vinodhiniceg/LVDT_project-ID-337/lvs/README.md

## LVS

Results of the LVS procedure for the blocks:

- charge pump
- colpitts + slope amp
- strongARM latch

are provided in this folder.
