vinodhiniceg/LVDT_project-ID-337/xschem/README.md

## Schematic Files

### Integrated Colpitts Oscillator and Slope Amplifier

The schematic file is `colpitts_slopeamp.sch` and it contains the testbench to run the transient simulation.

### FDC

The top level block is named `FDC_complete_loop.sch` and it contains the whole FDC (including the digital portions built using standard cells and custom made cells).
