vinodhiniceg/LVDT_project-ID-337/layout/magic/README.md

### Layout

The flattened layout files are as follows:

1. `chargepump_flat.mag`
2. `colpitts_slopeamp_flat.mag`
3. `strongarmlatch_flat.mag`
