vinodhiniceg/LVDT_project-ID-337/postlayout/colpitts_slopeamp_postlayout.png

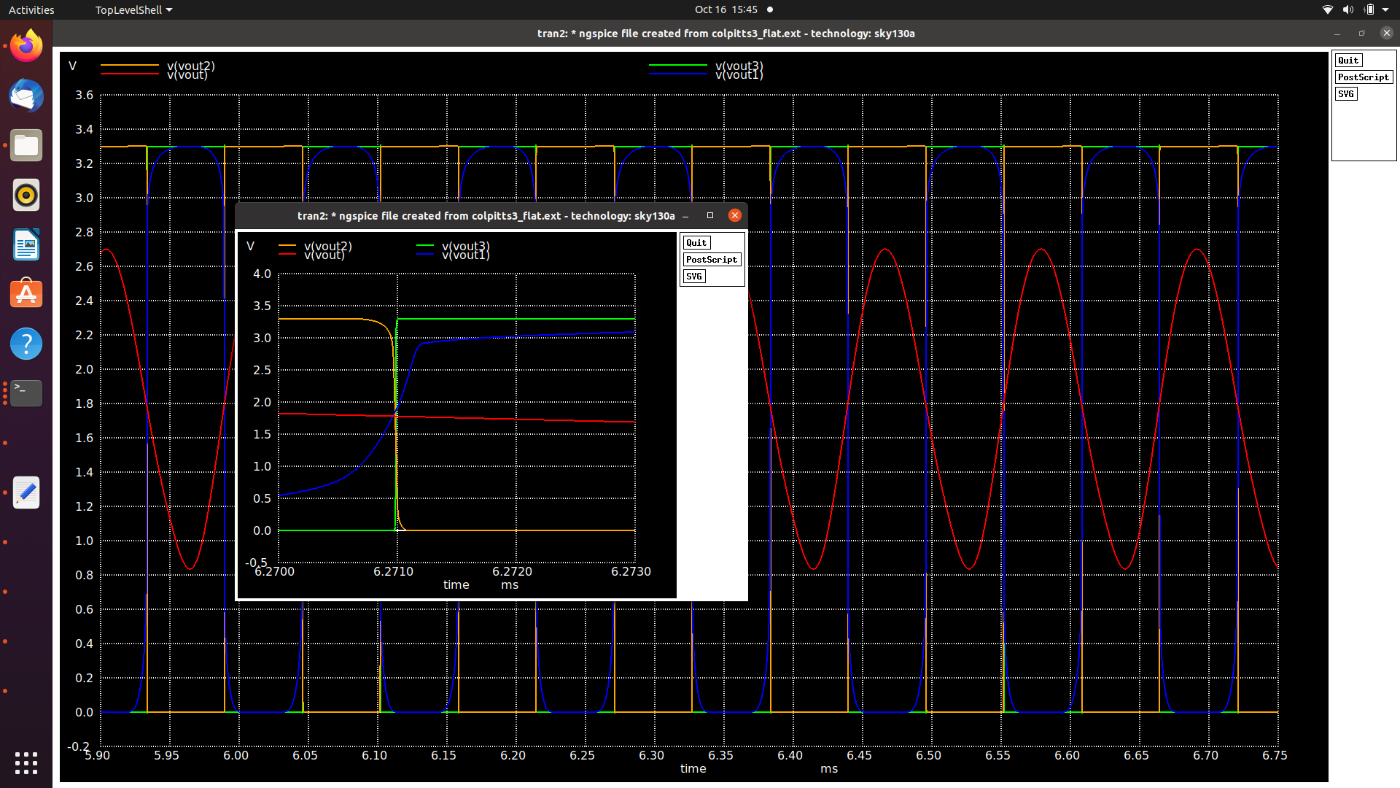
postlayout/colpitts_slopeamp_postlayout.png
