vinodhiniceg/LVDT_project-ID-337/postlayout/chargepump_postextracted.spice

**.subckt chargepump
V2 out1b vssa pulse 3.3 0 1n 1n 1n 50u 100u
V5 vdda vssa 3.3
C10 vc vssa 100p m=1
I1 Iin vssa 1u
V4 out2 vssa pulse 0 3.3 50u 1n 1n 45u 100u
V1 vssa GND 0

X0 dg.t2 dg.t1 vssa vssa sky130_fd_pr__nfet_g5v0d10v5 ad=0p pd=0u as=0p ps=0u w=1e+06u l=1e+06u
X1 vdda.t4 Iin.t0 Iin.t1 vdda.t2 sky130_fd_pr__pfet_g5v0d10v5 ad=0p pd=0u as=0p ps=0u w=1e+06u l=1e+06u
X2 vssa dg.t3 nc.t1 vssa sky130_fd_pr__nfet_g5v0d10v5 ad=0p pd=0u as=0p ps=0u w=1e+06u l=1e+06u
X3 nc dg vssa vssa sky130_fd_pr__nfet_g5v0d10v5 ad=0p pd=0u as=0p ps=0u w=1e+06u l=1e+06u M=33
X4 vdda.t3 Iin.t2 pc.t0 vdda.t2 sky130_fd_pr__pfet_g5v0d10v5 ad=0p pd=0u as=0p ps=0u w=1e+06u l=1e+06u
X5 dg.t0 Iin.t3 vdda.t1 vdda.t0 sky130_fd_pr__pfet_g5v0d10v5 ad=0p pd=0u as=0p ps=0u w=1e+06u l=1e+06u
X6 vc out1b pc.t1 vdda.t2 sky130_fd_pr__pfet_g5v0d10v5 ad=0p pd=0u as=0p ps=0u w=1e+06u l=1e+06u
X7 vssa dg dg vssa sky130_fd_pr__nfet_g5v0d10v5 ad=0p pd=0u as=0p ps=0u w=1e+06u l=1e+06u M=9
X8 nc.t0 out2 vc vssa sky130_fd_pr__nfet_g5v0d10v5 ad=0p pd=0u as=0p ps=0u w=1e+06u l=1e+06u
X9 vdda Iin Iin vdda sky130_fd_pr__pfet_g5v0d10v5 ad=0p pd=0u as=0p ps=0u w=1e+06u l=1e+06u M=9
X10 pc Iin vdda vdda sky130_fd_pr__pfet_g5v0d10v5 ad=0p pd=0u as=0p ps=0u w=1e+06u l=1e+06u M=39
X11 vc out1b pc vdda sky130_fd_pr__pfet_g5v0d10v5 ad=0p pd=0u as=0p ps=0u w=1e+06u l=1e+06u M=9
X12 vc out2 nc vssa sky130_fd_pr__nfet_g5v0d10v5 ad=0p pd=0u as=0p ps=0u w=1e+06u l=1e+06u M=9
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
C0 nc vssa 16.05fF
C1 dg vssa 13.35fF
C2 vdda vssa 55.44fF
C3 vdda.t2 vssa 24.26fF
**** begin user architecture code

.lib ~/open_pdks/sky130/sky130A/libs.tech/ngspice/sky130.lib.spice tt
.include /home/vinodhini/open_pdks/sky130/sky130A/libs.ref/sky130_fd_sc_hvl/spice/sky130_fd_sc_hvl.spice

*.MODEL swmod SW(VT=0.0 VH=0.01 RON=1 ROFF=10000000000)
.param mc_mm_switch=0
.param mc_pr_switch=0


.tran 2.5u 2.5m
.options gmin=1E-11
.options savecurrents
.save out1b out2 vc

**** end user architecture code
**.ends
.GLOBAL GND
** flattened .save nodes
.save out1b out2 vc
.end
