vinodhiniceg/LVDT_project-ID-337/postlayout/colpitts_slopeamp_postextracted.spice

* NGSPICE file created from colpitts4_flat.ext - technology: sky130A


* Top level circuit colpitts4_flat

X0 vout2.t1 vout1.t2 vdda vdda sky130_fd_pr__pfet_g5v0d10v5 ad=0p pd=0u as=0p ps=0u w=3e+06u l=3e+06u
X1 bot bot bot bot sky130_fd_pr__nfet_g5v0d10v5 ad=0p pd=0u as=0p ps=0u w=3e+06u l=3e+06u M=138
X2 vout2 vout1 vdda vdda sky130_fd_pr__pfet_g5v0d10v5 ad=0p pd=0u as=0p ps=0u w=3e+06u l=3e+06u M=199
X3 bot bot bot bot sky130_fd_pr__nfet_g5v0d10v5 ad=0p pd=0u as=0p ps=0u w=5e+06u l=5e+06u M=1450
X4 vdda vdda vdda vdda sky130_fd_pr__pfet_g5v0d10v5 ad=0p pd=0u as=0p ps=0u w=3e+06u l=3e+06u M=1016
X5 vcap.t0 vin1 vout.t0 bot sky130_fd_pr__nfet_g5v0d10v5 ad=0p pd=0u as=0p ps=0u w=5e+06u l=5e+06u
X6 bot vout1.t3 vout2.t0 bot sky130_fd_pr__nfet_g5v0d10v5 ad=0p pd=0u as=0p ps=0u w=3e+06u l=3e+06u
X7 vout vin1 vcap bot sky130_fd_pr__nfet_g5v0d10v5 ad=0p pd=0u as=0p ps=0u w=5e+06u l=5e+06u M=524
X8 vout1.t0 vout.t1 vdda vdda sky130_fd_pr__pfet_g5v0d10v5 ad=0p pd=0u as=0p ps=0u w=3e+06u l=3e+06u
X9 vout1 vout vdda vdda sky130_fd_pr__pfet_g5v0d10v5 ad=0p pd=0u as=0p ps=0u w=3e+06u l=3e+06u M=183
X10 bot vin2 vcap.t1 bot sky130_fd_pr__nfet_g5v0d10v5 ad=0p pd=0u as=0p ps=0u w=5e+06u l=5e+06u
X11 vout3.t1 vout2.t2 vdda vdda sky130_fd_pr__pfet_g5v0d10v5 ad=0p pd=0u as=0p ps=0u w=3e+06u l=3e+06u
X12 vcap vin2 bot bot sky130_fd_pr__nfet_g5v0d10v5 ad=0p pd=0u as=0p ps=0u w=5e+06u l=5e+06u M=199
X13 vdda vout2 vout3 vdda sky130_fd_pr__pfet_g5v0d10v5 ad=0p pd=0u as=0p ps=0u w=3e+06u l=3e+06u M=123
X14 vout3.t0 vout2.t3 bot bot sky130_fd_pr__nfet_g5v0d10v5 ad=0p pd=0u as=0p ps=0u w=3e+06u l=3e+06u
X15 vout2 vout1 bot bot sky130_fd_pr__nfet_g5v0d10v5 ad=0p pd=0u as=0p ps=0u w=3e+06u l=3e+06u M=24
X16 bot vout.t2 vout1.t1 bot sky130_fd_pr__nfet_g5v0d10v5 ad=0p pd=0u as=0p ps=0u w=3e+06u l=3e+06u
X17 vout1 vout bot bot sky130_fd_pr__nfet_g5v0d10v5 ad=0p pd=0u as=0p ps=0u w=3e+06u l=3e+06u M=19
X18 vout3 vout2 bot bot sky130_fd_pr__nfet_g5v0d10v5 ad=0p pd=0u as=0p ps=0u w=3e+06u l=3e+06u M=23
X19 a_85326_53811# a_83611_53805# a_85147_53811# vdda sky130_fd_pr__pfet_g5v0d10v5 ad=0p pd=0u as=0p ps=0u w=420000u l=500000u
X20 vout3.t2 bot sky130_fd_pr__cap_mim_m3_1 l=2e+07u w=2.5e+07u
X21 a_84193_53900# a_83611_53805# a_83724_53900# vdda sky130_fd_pr__pfet_g5v0d10v5 ad=0p pd=0u as=0p ps=0u w=420000u l=500000u
X22 vout2.t4 bot sky130_fd_pr__cap_mim_m3_1 l=2e+07u w=2.5e+07u
X23 a_85659_53375# vdda bot bot sky130_fd_pr__nfet_g5v0d10v5 ad=0p pd=0u as=0p ps=0u w=420000u l=500000u
X24 a_83611_53805# a_83302_53375.t2 vdda vdda sky130_fd_pr__pfet_g5v0d10v5 ad=0p pd=0u as=0p ps=0u w=750000u l=500000u
X25 vdda clkin a_83302_53375.t1 vdda sky130_fd_pr__pfet_g5v0d10v5 ad=0p pd=0u as=0p ps=0u w=750000u l=500000u
X26 vout1.t4 bot sky130_fd_pr__cap_mim_m3_1 l=2e+07u w=2.5e+07u
X27 a_84391_53774# a_84193_53900# bot bot sky130_fd_pr__nfet_g5v0d10v5 ad=0p pd=0u as=0p ps=0u w=750000u l=500000u
X28 vdda a_85147_53811# a_85921_53475# vdda sky130_fd_pr__pfet_g5v0d10v5 ad=0p pd=0u as=0p ps=0u w=750000u l=500000u
X29 a_84363_53441# a_83611_53805# a_84193_53900# bot sky130_fd_pr__nfet_g5v0d10v5 ad=0p pd=0u as=0p ps=0u w=420000u l=500000u
X30 bot a_85368_53685# a_85361_53375# bot sky130_fd_pr__nfet_g5v0d10v5 ad=0p pd=0u as=0p ps=0u w=420000u l=500000u
X31 dfout a_85921_53475# bot bot sky130_fd_pr__nfet_g5v0d10v5 ad=0p pd=0u as=0p ps=0u w=750000u l=500000u
X32 a_84391_53774# a_84193_53900# vdda vdda sky130_fd_pr__pfet_g5v0d10v5 ad=0p pd=0u as=0p ps=0u w=1e+06u l=500000u
X33 bot a_85147_53811# a_85921_53475# bot sky130_fd_pr__nfet_g5v0d10v5 ad=0p pd=0u as=0p ps=0u w=420000u l=500000u
X34 vdda vdda a_83724_53900# vdda sky130_fd_pr__pfet_g5v0d10v5 ad=0p pd=0u as=0p ps=0u w=420000u l=500000u
X35 a_84349_53900# a_83302_53375.t3 a_84193_53900# vdda sky130_fd_pr__pfet_g5v0d10v5 ad=0p pd=0u as=0p ps=0u w=420000u l=500000u
X36 a_84193_53900# vdda vdda vdda sky130_fd_pr__pfet_g5v0d10v5 ad=0p pd=0u as=0p ps=0u w=420000u l=500000u
X37 vdda a_85368_53685# a_85326_53811# vdda sky130_fd_pr__pfet_g5v0d10v5 ad=0p pd=0u as=0p ps=0u w=420000u l=500000u
X38 a_83611_53805# a_83302_53375.t4 bot bot sky130_fd_pr__nfet_g5v0d10v5 ad=0p pd=0u as=0p ps=0u w=420000u l=500000u
X39 vout3 bot sky130_fd_pr__cap_mim_m3_1 l=2e+07u w=2.5e+07u
X40 bot clkin a_83302_53375.t0 bot sky130_fd_pr__nfet_g5v0d10v5 ad=0p pd=0u as=0p ps=0u w=420000u l=500000u
X41 a_83909_53441# vdda bot bot sky130_fd_pr__nfet_g5v0d10v5 ad=0p pd=0u as=0p ps=0u w=420000u l=500000u
X42 vdda a_84391_53774# a_84349_53900# vdda sky130_fd_pr__pfet_g5v0d10v5 ad=0p pd=0u as=0p ps=0u w=420000u l=500000u
X43 a_85147_53811# a_83302_53375.t5 a_84391_53774# vdda sky130_fd_pr__pfet_g5v0d10v5 ad=0p pd=0u as=0p ps=0u w=1e+06u l=500000u
X44 vout2 bot sky130_fd_pr__cap_mim_m3_1 l=2e+07u w=2.5e+07u
X45 a_83724_53900# vout3.t3 a_83909_53441# bot sky130_fd_pr__nfet_g5v0d10v5 ad=0p pd=0u as=0p ps=0u w=420000u l=500000u
X46 vout1 bot sky130_fd_pr__cap_mim_m3_1 l=2e+07u w=2.5e+07u
X47 vout2 bot sky130_fd_pr__cap_mim_m3_1 l=2e+07u w=2.5e+07u
X48 bot vdda a_84505_53441# bot sky130_fd_pr__nfet_g5v0d10v5 ad=0p pd=0u as=0p ps=0u w=420000u l=500000u
X49 a_83724_53900# vout3.t4 vdda vdda sky130_fd_pr__pfet_g5v0d10v5 ad=0p pd=0u as=0p ps=0u w=420000u l=500000u
X50 vdda a_85147_53811# a_85368_53685# vdda sky130_fd_pr__pfet_g5v0d10v5 ad=0p pd=0u as=0p ps=0u w=420000u l=500000u
X51 a_85368_53685# vdda vdda vdda sky130_fd_pr__pfet_g5v0d10v5 ad=0p pd=0u as=0p ps=0u w=420000u l=500000u
X52 a_85361_53375# a_83302_53375.t6 a_85147_53811# bot sky130_fd_pr__nfet_g5v0d10v5 ad=0p pd=0u as=0p ps=0u w=420000u l=500000u
X53 a_85368_53685# a_85147_53811# a_85659_53375# bot sky130_fd_pr__nfet_g5v0d10v5 ad=0p pd=0u as=0p ps=0u w=420000u l=500000u
X54 vout1 bot sky130_fd_pr__cap_mim_m3_1 l=2e+07u w=2.5e+07u
X55 a_84193_53900# a_83302_53375.t7 a_83724_53900# bot sky130_fd_pr__nfet_g5v0d10v5 ad=0p pd=0u as=0p ps=0u w=420000u l=500000u
X56 a_85147_53811# a_83611_53805# a_84391_53774# bot sky130_fd_pr__nfet_g5v0d10v5 ad=0p pd=0u as=0p ps=0u w=750000u l=500000u
X57 vout1 bot sky130_fd_pr__cap_mim_m3_1 l=2e+07u w=2.5e+07u
X58 vout1 bot sky130_fd_pr__cap_mim_m3_1 l=2e+07u w=2.5e+07u
X59 dfout a_85921_53475# vdda vdda sky130_fd_pr__pfet_g5v0d10v5 ad=0p pd=0u as=0p ps=0u w=1.5e+06u l=500000u
X60 a_84505_53441# a_84391_53774# a_84363_53441# bot sky130_fd_pr__nfet_g5v0d10v5 ad=0p pd=0u as=0p ps=0u w=420000u l=500000u
R0 vout1.n0 vout1.t1 1554.43
R1 vout1 vout1.n279 1537.99
R2 vout1.n280 vout1 703.239
R3 vout1.n246 vout1.n245 381.257
R4 vout1.n159 vout1.n153 368.573
R5 vout1.n153 vout1.n95 368.573
R6 vout1.n248 vout1.n247 368.573
R7 vout1.n247 vout1.n246 363.643
R8 vout1.n248 vout1.n43 325.302
R9 vout1.n240 vout1.n239 317.928
R10 vout1.n159 vout1.n158 305.036
R11 vout1.n239 vout1.n233 271.976
R12 vout1.n280 vout1.t0 265.444
R13 vout1.n223 vout1.n222 257.825
R14 vout1.n212 vout1.n95 237.666
R15 vout1.n222 vout1.n221 235.213
R16 vout1.n89 vout1.n54 223.973
R17 vout1.n254 vout1.n38 159.889
R18 vout1.n170 vout1.n169 153.573
R19 vout1.n171 vout1.n119 153.566
R20 vout1.n107 vout1.n106 153.547
R21 vout1.n101 vout1.n100 153.516
R22 vout1.n148 vout1.n141 153.482
R23 vout1.n164 vout1.n163 152.655
R24 vout1.n207 vout1.n206 152.572
R25 vout1.n201 vout1.n200 152.572
R26 vout1.n33 vout1.n21 152.45
R27 vout1.n27 vout1.n26 152.394
R28 vout1.n260 vout1.n259 152.34
R29 vout1.n60 vout1.n59 152.321
R30 vout1.n44 vout1.n38 152.125
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
R738 vout.n210 vout.n209 48.2
R739 vout.n211 vout.n210 48.2
R740 vout.n55 vout.n54 48.2
R741 vout.n56 vout.n55 48.2
R742 vout.n203 vout.n202 48.2
R743 vout.n204 vout.n203 48.2
R744 vout.n51 vout.n50 48.2
R745 vout.n52 vout.n51 48.2
R746 vout.n108 vout.n107 48.2
R747 vout.n109 vout.n108 48.2
R748 vout.n58 vout.n57 48.2
R749 vout.n59 vout.n58 48.2
R750 vout.n200 vout.n199 48.2
R751 vout.n199 vout.n198 48.2
R752 vout.n196 vout.n195 48.2
R753 vout.n195 vout.n194 48.2
R754 vout.n66 vout.n65 48.2
R755 vout.n67 vout.n66 48.2
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
