vinodhiniceg/LVDT_project-ID-337/postlayout/strongarmlatch_postextraction.spice

**.subckt strongarmlatch

X0 sky130_fd_sc_hvl__inv_1_1/A.t0 sky130_fd_sc_hvl__inv_1_0/A.t3 a_n260_n1316.t1 vssa sky130_fd_pr__nfet_g5v0d10v5 ad=0p pd=0u as=0p ps=0u w=1e+06u l=500000u
X1 vom sky130_fd_sc_hvl__inv_1_0/A.t4 vssa vssa sky130_fd_pr__nfet_g5v0d10v5 ad=0p pd=0u as=0p ps=0u w=750000u l=500000u
X2 vp vm vssa vssa sky130_fd_pr__nfet_g5v0d10v5 ad=0p pd=0u as=0p ps=0u w=750000u l=500000u
X3 a_n260_n1316.t3 clk vdda.t20 vdda.t19 sky130_fd_pr__pfet_g5v0d10v5 ad=0p pd=0u as=0p ps=0u w=1e+06u l=500000u
X4 a_3148_n1460.t1 vref nmos8point5_0/d.t0 vssa sky130_fd_pr__nfet_g5v0d10v5 ad=0p pd=0u as=0p ps=0u w=1e+06u l=500000u
X5 a_n260_n1316.t2 vinp nmos8point5_0/d.t3 vssa sky130_fd_pr__nfet_g5v0d10v5 ad=0p pd=0u as=0p ps=0u w=1e+06u l=500000u
X6 sky130_fd_sc_hvl__inv_1_0/A.t1 sky130_fd_sc_hvl__inv_1_1/A.t3 a_3148_n1460.t0 vssa sky130_fd_pr__nfet_g5v0d10v5 ad=0p pd=0u as=0p ps=0u w=1e+06u l=500000u
X7 vp vm vdda.t11 vdda.t10 sky130_fd_pr__pfet_g5v0d10v5 ad=0p pd=0u as=0p ps=0u w=1.5e+06u l=500000u
X8 a_3148_n1460.t2 vinp nmos8point5_0/d.t2 vdda.t12 sky130_fd_pr__pfet_g5v0d10v5 ad=0p pd=0u as=0p ps=0u w=1e+06u l=500000u
X9 a_3148_n1460.t3 clk vdda.t18 vdda.t17 sky130_fd_pr__pfet_g5v0d10v5 ad=0p pd=0u as=0p ps=0u w=1e+06u l=500000u
X10 sky130_fd_sc_hvl__inv_1_1/A.t2 clk vdda.t16 vdda.t15 sky130_fd_pr__pfet_g5v0d10v5 ad=0p pd=0u as=0p ps=0u w=1e+06u l=500000u
X11 vm vp vssa vssa sky130_fd_pr__nfet_g5v0d10v5 ad=0p pd=0u as=0p ps=0u w=750000u l=500000u
X12 vdda.t14 clk sky130_fd_sc_hvl__inv_1_0/A.t2 vdda.t13 sky130_fd_pr__pfet_g5v0d10v5 ad=0p pd=0u as=0p ps=0u w=1e+06u l=500000u
X13 vssa vom vp vssa sky130_fd_pr__nfet_g5v0d10v5 ad=0p pd=0u as=0p ps=0u w=1e+06u l=500000u
X14 a_n260_n1316.t0 vref nmos8point5_0/d.t1 vdda.t6 sky130_fd_pr__pfet_g5v0d10v5 ad=0p pd=0u as=0p ps=0u w=1e+06u l=500000u
X15 vdda clk sky130_fd_sc_hvl__inv_1_0/A vdda sky130_fd_pr__pfet_g5v0d10v5 ad=0p pd=0u as=0p ps=0u w=1e+06u l=500000u M=7
X16 vdda clk sky130_fd_sc_hvl__inv_1_1/A vdda sky130_fd_pr__pfet_g5v0d10v5 ad=0p pd=0u as=0p ps=0u w=1e+06u l=500000u M=7
X17 vdda.t5 sky130_fd_sc_hvl__inv_1_1/A.t4 sky130_fd_sc_hvl__inv_1_0/A.t0 vdda.t4 sky130_fd_pr__pfet_g5v0d10v5 ad=0p pd=0u as=0p ps=0u w=1e+06u l=500000u
X18 vssa clk nmos8point5_0/d.t4 vssa sky130_fd_pr__nfet_g5v0d10v5 ad=0p pd=0u as=0p ps=0u w=1e+06u l=500000u
X19 vssa clk nmos8point5_0/d vssa sky130_fd_pr__nfet_g5v0d10v5 ad=0p pd=0u as=0p ps=0u w=1e+06u l=500000u M=7
X20 vdda sky130_fd_sc_hvl__inv_1_1/A sky130_fd_sc_hvl__inv_1_0/A vdda sky130_fd_pr__pfet_g5v0d10v5 ad=0p pd=0u as=0p ps=0u w=1e+06u l=500000u M=7
X21 vdda.t3 sky130_fd_sc_hvl__inv_1_1/A.t5 vop vdda.t2 sky130_fd_pr__pfet_g5v0d10v5 ad=0p pd=0u as=0p ps=0u w=1.5e+06u l=500000u
X22 vssa vop vm vssa sky130_fd_pr__nfet_g5v0d10v5 ad=0p pd=0u as=0p ps=0u w=1e+06u l=500000u
X23 sky130_fd_sc_hvl__inv_1_1/A.t1 sky130_fd_sc_hvl__inv_1_0/A.t5 vdda.t9 vdda.t4 sky130_fd_pr__pfet_g5v0d10v5 ad=0p pd=0u as=0p ps=0u w=1e+06u l=500000u
X24 sky130_fd_sc_hvl__inv_1_1/A sky130_fd_sc_hvl__inv_1_0/A vdda vdda sky130_fd_pr__pfet_g5v0d10v5 ad=0p pd=0u as=0p ps=0u w=1e+06u l=500000u M=7
X25 vm vp vdda.t1 vdda.t0 sky130_fd_pr__pfet_g5v0d10v5 ad=0p pd=0u as=0p ps=0u w=1.5e+06u l=500000u
X26 vssa sky130_fd_sc_hvl__inv_1_1/A.t6 vop vssa sky130_fd_pr__nfet_g5v0d10v5 ad=0p pd=0u as=0p ps=0u w=750000u l=500000u
X27 vom sky130_fd_sc_hvl__inv_1_0/A.t6 vdda.t8 vdda.t7 sky130_fd_pr__pfet_g5v0d10v5 ad=0p pd=0u as=0p ps=0u w=1.5e+06u l=500000u
R0 sky130_fd_sc_hvl__inv_1_0/A.n5 sky130_fd_sc_hvl__inv_1_0/A.n4 180.749
R1 sky130_fd_sc_hvl__inv_1_0/A.n12 sky130_fd_sc_hvl__inv_1_0/A.t5 176.013
R2 sky130_fd_sc_hvl__inv_1_0/A.n16 sky130_fd_sc_hvl__inv_1_0/A.n15 174.987
R3 sky130_fd_sc_hvl__inv_1_0/A.n11 sky130_fd_sc_hvl__inv_1_0/A.n10 174.484
R4 sky130_fd_sc_hvl__inv_1_0/A.n9 sky130_fd_sc_hvl__inv_1_0/A.n8 174.484
R5 sky130_fd_sc_hvl__inv_1_0/A.n13 sky130_fd_sc_hvl__inv_1_0/A.n12 167.397
R6 sky130_fd_sc_hvl__inv_1_0/A.n14 sky130_fd_sc_hvl__inv_1_0/A.n9 166.666
R7 sky130_fd_sc_hvl__inv_1_0/A.n14 sky130_fd_sc_hvl__inv_1_0/A.n13 133.803
R8 sky130_fd_sc_hvl__inv_1_0/A.n6 sky130_fd_sc_hvl__inv_1_0/A.n5 125.893
R9 sky130_fd_sc_hvl__inv_1_0/A.n0 sky130_fd_sc_hvl__inv_1_0/A.t6 114.03
R10 sky130_fd_sc_hvl__inv_1_0/A.n7 sky130_fd_sc_hvl__inv_1_0/A.t3 95.159
R11 sky130_fd_sc_hvl__inv_1_0/A.n17 sky130_fd_sc_hvl__inv_1_0/A.n16 84.269
R12 sky130_fd_sc_hvl__inv_1_0/A.n0 sky130_fd_sc_hvl__inv_1_0/A.t4 81.587
R13 sky130_fd_sc_hvl__inv_1_0/A sky130_fd_sc_hvl__inv_1_0/A.n19 61.029
R14 sky130_fd_sc_hvl__inv_1_0/A.n6 sky130_fd_sc_hvl__inv_1_0/A.n2 57.84
R15 sky130_fd_sc_hvl__inv_1_0/A.n5 sky130_fd_sc_hvl__inv_1_0/A.n3 48.2
R16 sky130_fd_sc_hvl__inv_1_0/A.n13 sky130_fd_sc_hvl__inv_1_0/A.n11 48.2
R17 sky130_fd_sc_hvl__inv_1_0/A.n15 sky130_fd_sc_hvl__inv_1_0/A.n14 48.2
R18 sky130_fd_sc_hvl__inv_1_0/A.n18 sky130_fd_sc_hvl__inv_1_0/A.t2 29.745
R19 sky130_fd_sc_hvl__inv_1_0/A.n17 sky130_fd_sc_hvl__inv_1_0/A.t0 28.19
R20 sky130_fd_sc_hvl__inv_1_0/A.n19 sky130_fd_sc_hvl__inv_1_0/A.t1 21.994
R21 sky130_fd_sc_hvl__inv_1_0/A.n19 sky130_fd_sc_hvl__inv_1_0/A.n7 11.124
R22 sky130_fd_sc_hvl__inv_1_0/A.n7 sky130_fd_sc_hvl__inv_1_0/A.n6 11.093
R23 sky130_fd_sc_hvl__inv_1_0/A sky130_fd_sc_hvl__inv_1_0/A.n1 11.051
R24 sky130_fd_sc_hvl__inv_1_0/A.n1 sky130_fd_sc_hvl__inv_1_0/A.n0 8.74
R25 sky130_fd_sc_hvl__inv_1_0/A.n1 sky130_fd_sc_hvl__inv_1_0/A 6.616
R26 sky130_fd_sc_hvl__inv_1_0/A.n18 sky130_fd_sc_hvl__inv_1_0/A.n17 2.664
R27 sky130_fd_sc_hvl__inv_1_0/A.n19 sky130_fd_sc_hvl__inv_1_0/A.n18 1.375
R28 a_n260_n1316.n0 a_n260_n1316.t3 30.627
R29 a_n260_n1316.n0 a_n260_n1316.t0 30.366
R30 a_n260_n1316.n1 a_n260_n1316.t1 20.24
R31 a_n260_n1316.t2 a_n260_n1316.n1 20.076
R32 a_n260_n1316.n1 a_n260_n1316.n0 8.019
R33 sky130_fd_sc_hvl__inv_1_1/A.n14 sky130_fd_sc_hvl__inv_1_1/A.n13 176.013
R34 sky130_fd_sc_hvl__inv_1_1/A.n9 sky130_fd_sc_hvl__inv_1_1/A.n8 174.987
R35 sky130_fd_sc_hvl__inv_1_1/A.n10 sky130_fd_sc_hvl__inv_1_1/A.t4 174.484
R36 sky130_fd_sc_hvl__inv_1_1/A.n7 sky130_fd_sc_hvl__inv_1_1/A.n6 174.484
R37 sky130_fd_sc_hvl__inv_1_1/A.n13 sky130_fd_sc_hvl__inv_1_1/A.n12 167.397
R38 sky130_fd_sc_hvl__inv_1_1/A.n11 sky130_fd_sc_hvl__inv_1_1/A.n10 166.666
R39 sky130_fd_sc_hvl__inv_1_1/A.n4 sky130_fd_sc_hvl__inv_1_1/A.n3 163.879
R40 sky130_fd_sc_hvl__inv_1_1/A.n1 sky130_fd_sc_hvl__inv_1_1/A.t3 148.951
R41 sky130_fd_sc_hvl__inv_1_1/A.n12 sky130_fd_sc_hvl__inv_1_1/A.n11 133.803
R42 sky130_fd_sc_hvl__inv_1_1/A.n19 sky130_fd_sc_hvl__inv_1_1/A.t5 114.03
R43 sky130_fd_sc_hvl__inv_1_1/A.n15 sky130_fd_sc_hvl__inv_1_1/A.n14 108.659
R44 sky130_fd_sc_hvl__inv_1_1/A.n19 sky130_fd_sc_hvl__inv_1_1/A.t6 81.587
R45 sky130_fd_sc_hvl__inv_1_1/A.n11 sky130_fd_sc_hvl__inv_1_1/A.n9 48.2
R46 sky130_fd_sc_hvl__inv_1_1/A.n12 sky130_fd_sc_hvl__inv_1_1/A.n7 48.2
R47 sky130_fd_sc_hvl__inv_1_1/A.n4 sky130_fd_sc_hvl__inv_1_1/A.n2 48.2
R48 sky130_fd_sc_hvl__inv_1_1/A.n1 sky130_fd_sc_hvl__inv_1_1/A.n0 48.2
R49 sky130_fd_sc_hvl__inv_1_1/A sky130_fd_sc_hvl__inv_1_1/A.n18 29.615
R50 sky130_fd_sc_hvl__inv_1_1/A.n16 sky130_fd_sc_hvl__inv_1_1/A.t2 28.19
R51 sky130_fd_sc_hvl__inv_1_1/A.n15 sky130_fd_sc_hvl__inv_1_1/A.t1 28.19
R52 sky130_fd_sc_hvl__inv_1_1/A.n18 sky130_fd_sc_hvl__inv_1_1/A.t0 21.793
R53 sky130_fd_sc_hvl__inv_1_1/A.n5 sky130_fd_sc_hvl__inv_1_1/A.n4 19.54
R54 sky130_fd_sc_hvl__inv_1_1/A.n5 sky130_fd_sc_hvl__inv_1_1/A.n1 16.283
R55 sky130_fd_sc_hvl__inv_1_1/A sky130_fd_sc_hvl__inv_1_1/A.n20 10.83
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
R190 a_3148_n1460.n1 a_3148_n1460.t0 19.538
R191 a_3148_n1460.t1 a_3148_n1460.n1 16.77
R192 a_3148_n1460.n1 a_3148_n1460.n0 7.374



V1 vdda vssa 3.3
V2 vssa GND 0
V3 clk vssa pulse 0 3.3 1n 1n 1n 2u 5u
V4 vref vssa sin 1.65 1.65 10K
V5 vinp vssa 1.65
**** begin user architecture code


.tran 1u 1m
.options gmin=1E-11
.save vinp vref clk vom vop vm vp

  .lib /home/vinodhini/open_pdks/sky130/sky130A/libs.tech/ngspice/sky130.lib.spice tt
**** end user architecture code
**.ends
.GLOBAL GND
** flattened .save nodes
.save vinp vref clk vom vop vm vp
.end
