vinodhiniceg/LVDT_project-ID-337/(commit log)

2021-10-23 Major changes
    [FDC_complete_loop.sch, FDC_short_check1.sch, adc1.sch, adder.sch, carry3.51.sch, chargepump.sch, chargepump_lvs.sch, colpitts_slopeamp.sch]
2021-10-25 charge pump postlayout spice netlist has been added
